louismomo66/field-eyes_pcb/field_eyes_v2_bom.csv

Refs | Value | Footprint | Qty | DNP
BT101 | 18650 Li-ion 3000mAh | field_eyes:BatteryHolder_Keystone_1042_1x18650_2pegs | 1
C101,C114 | 22uF 25V | Capacitor_SMD:C_1206_3216Metric | 2
C102,C103,C106,C107,C203,C310,C401,C402,C404,C406,C407 | 100nF | Capacitor_SMD:C_0603_1608Metric | 11
C104 | 220nF | Capacitor_SMD:C_0603_1608Metric | 1
C105,C113 | 22uF 10V | Capacitor_SMD:C_0805_2012Metric | 2
C108,C111,C202 | 10uF | Capacitor_SMD:C_0805_2012Metric | 3
C109,C110 | 47nF | Capacitor_SMD:C_0603_1608Metric | 2
C112,C201,C309,C409 | 1uF | Capacitor_SMD:C_0603_1608Metric | 4
C204 | 47uF 6.3V | Capacitor_SMD:C_1206_3216Metric | 1
C301 | 470uF 6.3V low-ESR | Capacitor_Tantalum_SMD:CP_EIA-7343-31_Kemet-D | 1
C302 | 22uF | Capacitor_SMD:C_0805_2012Metric | 1
C303 | 1uF | Capacitor_SMD:C_0402_1005Metric | 1
C304 | 100nF | Capacitor_SMD:C_0402_1005Metric | 1
C305,C313 | 33pF | Capacitor_SMD:C_0402_1005Metric | 2
C306 | 10pF | Capacitor_SMD:C_0402_1005Metric | 1
C307,C308 | 1nF | Capacitor_SMD:C_0603_1608Metric | 2
C311,C312 | NM | Capacitor_SMD:C_0402_1005Metric | 2 | DNP
C403 | 4700uF 16V | Capacitor_THT:CP_Radial_D12.5mm_P5.00mm | 1
C405,C408 | 330nF 25V | Capacitor_SMD:C_0603_1608Metric | 2
D101,D102,D103,D403 | SS14 | Diode_SMD:D_SMA | 4
D301 | ESD5Z5.0T1G | Diode_SMD:D_SOD-523 | 1
D302 | RED 0603 | LED_SMD:LED_0603_1608Metric | 1
D401,D402 | SM712 | Package_TO_SOT_SMD:SOT-23 | 2
FB301 | BLM21PG300SN1D | Inductor_SMD:L_0805_2012Metric | 1
H201,H202,H203,H204 | M3 | MountingHole:MountingHole_3.2mm_M3 | 4
J101 | SOLAR 6V | TerminalBlock_Phoenix:TerminalBlock_Phoenix_PT-1,5-2-3.5-H_1x02_P3.50mm_Horizontal | 1
J301 | U.FL LTE | Connector_Coaxial:U.FL_Hirose_U.FL-R-SMT-1_Vertical | 1
J302 | SIM holder (TE 2199337-5) | field_eyes:TE_2199337-5 | 1
J303 | MODEM USB (DNP) | Connector_PinHeader_1.27mm:PinHeader_1x06_P1.27mm_Vertical | 1 | DNP
J304 | U.FL GPS | Connector_Coaxial:U.FL_Hirose_U.FL-R-SMT-1_Vertical | 1
J403 | VALVE coil | TerminalBlock_Phoenix:TerminalBlock_Phoenix_PT-1,5-2-3.5-H_1x02_P3.50mm_Horizontal | 1
JP401 | VALVE SUPPLY | Jumper:SolderJumper-3_P1.3mm_Bridged12_RoundedPad1.0x1.5mm | 1
L101,L102 | 22uH 2A shielded | Inductor_SMD:L_Bourns_SRN6045TA | 2
L301 | 56nH | Inductor_SMD:L_0805_2012Metric | 1
Q101,Q102,Q105,Q107 | AO3401A | Package_TO_SOT_SMD:SOT-23 | 4
Q103,Q106,Q108 | 2N7002 | Package_TO_SOT_SMD:SOT-23 | 3
Q104 | FS8205 | Package_TO_SOT_SMD:SOT-23-6 | 1
Q201,Q202,Q301,Q302,Q303,Q304,Q305,Q306,Q401,Q402 | MMBT3904 | Package_TO_SOT_SMD:SOT-23 | 10
R101,R115,R120,R201,R202,R203,R204,R207,R310,R319,R402,R412 | 10k | Resistor_SMD:R_0603_1608Metric | 12
R103 | 0R12 1% 0.25W | Resistor_SMD:R_1206_3216Metric | 1
R104 | 120R | Resistor_SMD:R_0603_1608Metric | 1
R105 | 348k 1% | Resistor_SMD:R_0603_1608Metric | 1
R106 | 100k 1% | Resistor_SMD:R_0603_1608Metric | 1
R107,R108,R114,R116,R117,R421,R422 | 100k | Resistor_SMD:R_0603_1608Metric | 7
R109 | 100R | Resistor_SMD:R_0603_1608Metric | 1
R110,R320,R321 | 1k | Resistor_SMD:R_0603_1608Metric | 3
R111,R112 | 470k 1% | Resistor_SMD:R_0603_1608Metric | 2
R113,R119 | 10k 1% | Resistor_SMD:R_0603_1608Metric | 2
R118 | 191k 1% | Resistor_SMD:R_0603_1608Metric | 1
R205,R206,R301,R303,R305,R306,R307,R308,R309,R311,R401,R403,R404,R411,R413,R414 | 4.7k | Resistor_SMD:R_0603_1608Metric | 16
R302,R304,R312 | 47k | Resistor_SMD:R_0603_1608Metric | 3
R313 | 2.2k | Resistor_SMD:R_0603_1608Metric | 1
R314,R315,R316 | 22R | Resistor_SMD:R_0603_1608Metric | 3
R317 | 0R | Resistor_SMD:R_0402_1005Metric | 1
R318 | 0R | Resistor_SMD:R_0603_1608Metric | 1
R405,R406,R415,R416 | 10R | Resistor_SMD:R_0603_1608Metric | 4
R407,R417 | 120R | Resistor_SMD:R_0603_1608Metric | 2 | DNP
R423,R425 | 3.3k | Resistor_SMD:R_0603_1608Metric | 2
R424,R426 | 6.8k | Resistor_SMD:R_0603_1608Metric | 2
SV1 | PROG (as old SV1) | field_eyes:MA03-2 | 1
TH101 | 10k B3950 (under cell) | Resistor_SMD:R_0603_1608Metric | 1
TP301 | STATUS | TestPoint:TestPoint_Pad_D1.5mm | 1
U101 | CN3791 | Package_SO:SSOP-10_3.9x4.9mm_P1.00mm | 1
U102 | DW01A | Package_TO_SOT_SMD:SOT-23-6 | 1
U103 | XC6220B331MR | Package_TO_SOT_SMD:SOT-23-5 | 1
U104 | MT3608 | Package_TO_SOT_SMD:SOT-23-6 | 1
U201 | ESP32-WROOM-32D | RF_Module:ESP32-WROOM-32D | 1
U301 | A7672S | field_eyes:A7672S | 1
U302 | SMF05C | Package_TO_SOT_SMD:SOT-363_SC-70-6 | 1
U401,U402 | MAX485ESA+T | Package_SO:SOIC-8_3.9x4.9mm_P1.27mm | 2
U403 | MX1508 | Package_SO:SOIC-16_3.9x9.9mm_P1.27mm | 1
U404 | L78L09 | Package_TO_SOT_SMD:SOT-89-3 | 1
U405 | L78L05 | Package_TO_SOT_SMD:SOT-89-3 | 1
X1 | 7-in-1 NPK (A B 12V GND) | field_eyes:JST_XH_04_LongPad | 1
X2 | SMT100 (A B 12V GND) | field_eyes:JST_XH_04_LongPad | 1
X3 | OLED (3V3 GND SDA SCL) | field_eyes:JST_XH_04_LongPad | 1
X4 | DHT22 (NC 3V3 DATA GND) | field_eyes:JST_XH_04_LongPad | 1
