louismomo66/field-eyes_pcb/routing/gnd_result.txt

FAIL GND 103.33 53.275
SEG GND 0 0.35 62.1 46.9 67.1 46.9
SEG GND 0 0.35 67.1 46.9 67.2 46.8
SEG GND 1 0.35 67.2 46.8 68.1 45.9
SEG GND 1 0.35 68.1 45.9 68.2 45.9
SEG GND 1 0.35 68.2 45.9 68.3 45.8
SEG GND 1 0.35 68.3 45.8 68.8 45.8
SEG GND 1 0.35 68.8 45.8 69.2 46.2
SEG GND 1 0.35 69.2 46.2 69.2 46.3
SEG GND 1 0.35 69.2 46.3 69.3 46.4
SEG GND 1 0.35 69.3 46.4 69.3 46.8
SEG GND 1 0.35 69.3 46.8 69.5 47
VIA GND 67.2 46.8
SEG GND 0 0.35 62.076 46.893 62.1 46.9
OK GND 0.35
FAIL GND 71.14 9.93
FAIL GND 46.542 31.764
SEG GND 0 0.35 21.8 29.2 22.3 29.2
SEG GND 0 0.35 22.3 29.2 22.6 28.9
SEG GND 1 0.35 22.6 28.9 22.6 27.8
SEG GND 1 0.35 22.6 27.8 22.5 27.7
SEG GND 1 0.35 22.5 27.7 22.5 27.6
SEG GND 1 0.35 22.5 27.6 22.4 27.5
SEG GND 1 0.35 22.4 27.5 22.4 27.1
SEG GND 1 0.35 22.4 27.1 21.3 26
SEG GND 0 0.35 21.3 26 21.2 26
SEG GND 0 0.35 21.2 26 21.1 26.1
SEG GND 0 0.35 21.1 26.1 21 26.1
SEG GND 0 0.35 21 26.1 19.8 27.3
SEG GND 0 0.35 19.8 27.3 19.7 27.3
SEG GND 0 0.35 19.7 27.3 19.6 27.4
SEG GND 0 0.35 19.6 27.4 19.3 27.4
SEG GND 0 0.35 19.3 27.4 19.2 27.5
SEG GND 1 0.35 19.2 27.5 17 27.5
SEG GND 1 0.35 17 27.5 15.5 29
VIA GND 22.6 28.9
VIA GND 21.3 26
VIA GND 19.2 27.5
SEG GND 0 0.35 21.753 29.242 21.8 29.2
OK GND 0.35
FAIL GND 36.832 37.328
FAIL GND 40.326 29.577
SEG GND 0 0.35 26.6 36.6 27.1 36.6
SEG GND 0 0.35 27.1 36.6 27.3 36.8
SEG GND 0 0.35 27.3 36.8 27.4 36.8
SEG GND 0 0.35 27.4 36.8 27.5 36.9
SEG GND 0 0.35 27.5 36.9 28.2 36.9
SEG GND 0 0.35 28.2 36.9 28.3 36.8
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
SEG GND 1 0.35 17 27.5 15.5 29
VIA GND 25.7 32.3
VIA GND 21.3 26
VIA GND 19.2 27.5
SEG GND 0 0.35 26.985 32.113 27 32.1
OK GND 0.35
FAIL GND 41.799 34.005
FAIL GND 32.643 35.113
SEG GND 1 0.35 72 34 72 35.2
SEG GND 0 0.35 72 35.2 72.1 35.2
SEG GND 0 0.35 72.1 35.2 72.4 35.5
SEG GND 0 0.35 72.4 35.5 72.5 35.5
SEG GND 0 0.35 72.5 35.5 72.6 35.6
SEG GND 0 0.35 72.6 35.6 74.9 35.6
SEG GND 0 0.35 74.9 35.6 75.5 35
VIA GND 72 35.2
SEG GND 1 0.35 71.975 34 72 34
OK GND 0.35
