louismomo66/field-eyes_pcb/routing/result.txt

SEG /MODEM_VBAT 0 0.5 115.9 38.3 115.9 40
SEG /MODEM_VBAT 0 0.5 115.9 40 116 40.1
SEG /MODEM_VBAT 0 0.5 116 40.1 116 40.4
SEG /MODEM_VBAT 0 0.5 116 40.4 116.8 41.2
SEG /MODEM_VBAT 0 0.5 116.8 41.2 116.8 41.6
SEG /MODEM_VBAT 0 0.5 116.8 41.6 116.7 41.7
SEG /MODEM_VBAT 0 0.5 116.7 41.7 116.4 41.7
SEG /MODEM_VBAT 0 0.5 116.4 41.7 116 42.1
SEG /MODEM_VBAT 0 0.5 116 42.1 116 42.3
SEG /MODEM_VBAT 0 0.5 116 42.3 115.9 42.4
SEG /MODEM_VBAT 0 0.5 115.9 42.4 115.9 42.8
SEG /MODEM_VBAT 0 0.5 115.9 42.8 116 42.9
SEG /MODEM_VBAT 0 0.5 116 42.9 116 43.1
SEG /MODEM_VBAT 0 0.5 116 43.1 116.3 43.4
SEG /MODEM_VBAT 0 0.5 116.3 43.4 116.3 48
SEG /MODEM_VBAT 0 0.5 116.3 47 111.1 47
SEG /MODEM_VBAT 0 0.5 116.3 48 115.1 49.2
SEG /MODEM_VBAT 0 0.5 115.1 49.2 115.1 49.3
SEG /MODEM_VBAT 0 0.5 115.1 49.3 115 49.4
SEG /MODEM_VBAT 0 0.5 115 49.4 115 50.3
SEG /MODEM_VBAT 0 0.5 115 50.3 115.1 50.4
SEG /MODEM_VBAT 0 0.5 115.1 50.4 115.1 50.5
SEG /MODEM_VBAT 0 0.5 115.1 50.5 116.7 52.1
SEG /MODEM_VBAT 0 0.5 116.7 52.1 116.7 53
SEG /MODEM_VBAT 0 0.5 116.7 53 116.8 53.1
SEG /MODEM_VBAT 0 0.5 116.8 53.1 116.8 53.4
SEG /MODEM_VBAT 0 0.5 116.8 53.4 115.9 53.4
SEG /MODEM_VBAT 0 0.5 115.9 53.4 115.3 54
SEG /MODEM_VBAT 0 0.5 115.3 54 115 54
SEG /MODEM_VBAT 0 0.5 115 54 114.8 54.2
SEG /MODEM_VBAT 0 0.5 114.8 54.2 115.1 54.5
SEG /MODEM_VBAT 0 0.5 115.1 54.5 115.1 54.8
SEG /MODEM_VBAT 0 0.5 115.1 54.8 115.3 55
SEG /MODEM_VBAT 0 0.5 115.3 55 115.3 56.3
SEG /MODEM_VBAT 0 0.5 115.9 38.3 114.7 37.1
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
SEG GND 0 0.35 46.542 31.764 46.5 31.8
OK GND 0.35
SEG GND 0 0.35 26.6 36.6 27.9 36.6
SEG GND 0 0.35 27.9 36.6 28.3 36.2
SEG GND 0 0.35 28.3 36.2 31.5 36.2
SEG GND 0 0.35 31.5 36.2 32.6 35.1
SEG GND 0 0.35 26.618 36.553 26.6 36.6
SEG GND 0 0.35 32.643 35.113 32.6 35.1
OK GND 0.35
