louismomo66/field-eyes_pcb/field_eyes_v2.pdf

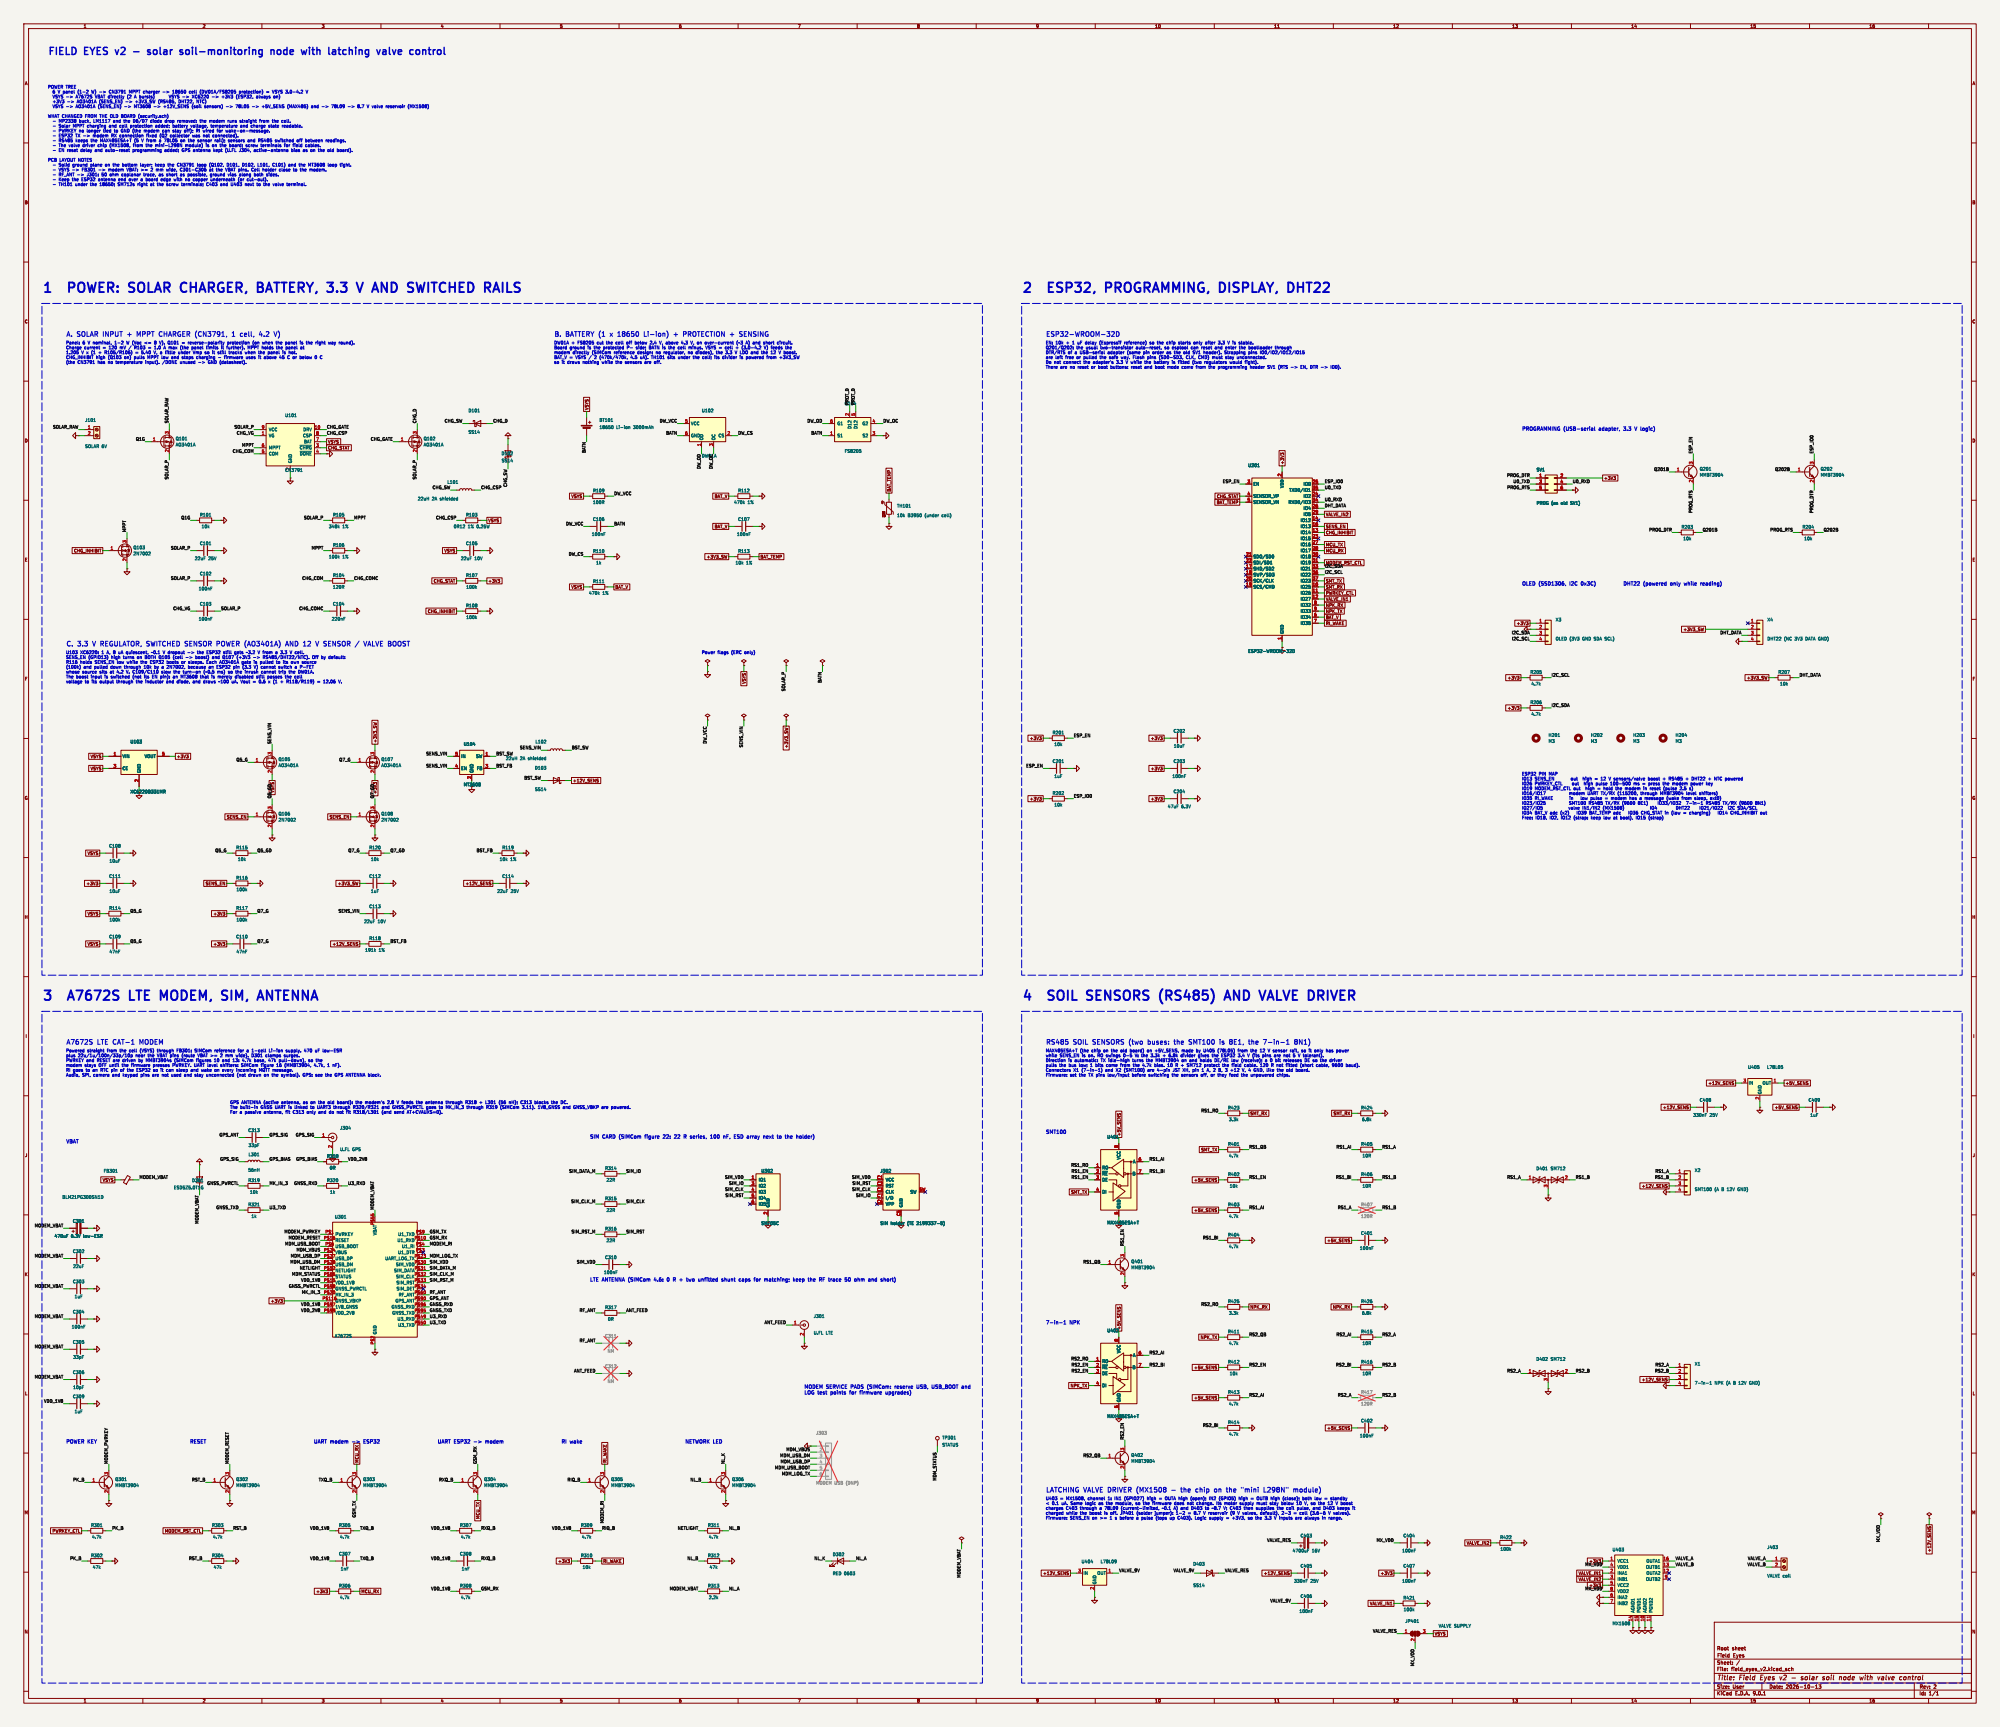
[picture p1: page 1]

1 POWER: SOLAR CHARGER, BATTERY, 3.3 V AND SWITCHED RAILS

so it draws nothing while the sensors are off.

2 DRV 10 CSP 8 BAT 7 ~{CHRG}3 ~{DONE}4 U101 CN3791

C. 3.3 V REGULATOR, SWITCHED SENSOR POWER (AO3401A) AND 12 V SENSOR / VALVE BOOST

Power flags (ERC only)

2 SW 1 FB 3 U104 MT3608 VIN 1 CE 3 GND

LTE ANTENNA (SIMCom 4.6: 0 R + two unfitted shunt caps for matching; keep the RF trace 50 ohm and short) SIM CARD (SIMCom figure 22: 22 R series, 100 nF, ESD array next to the holder)

J302 SIM holder (TE 2199337-5) VCC
C1 RST C2 CLK C3

PWRKEY P$1 RESET P$16 USB_BOOT P$6 VBUS P$24 USB_DP P$27 USB_DM P$28 NETLIGHT P$52 STATUS P$66 VDD_1V8 P$15 GNSS_PWRCTL P$98 MK_IN_3 P$20 GNSS_VBKP P$116
VDD_1V8 VDD_1V8TXQ_B MK_IN_3
