louismomo66/field-eyes_pcb/(list of files, drawings)

Other design files:
routing/field_eyes_v2.dsn
routing/field_eyes_v2_autoroute.dsn
