louismomo66/field-eyes_pcb/field_eyes_v2.kicad_pcb

## KiCad design field_eyes_v2.kicad_pcb (2026-10-22)

Schematic: field_eyes_v2.kicad_sch, Field Eyes v2 - solar soil node with valve control

Parts:
BT101: 18650 Li-ion 3000mAh; BatteryHolder_Keystone_1042_1x18650_2pegs
C101, C114: 22uF 25V; C_1206_3216Metric
C102, C103, C106, C107, C203, C310, C401, C402, C404, C406, C407: 100nF; C_0603_1608Metric
C104: 220nF; C_0603_1608Metric
C105, C113: 22uF 10V; C_0805_2012Metric
C108, C111, C202: 10uF; C_0805_2012Metric
C109, C110: 47nF; C_0603_1608Metric
C112, C201, C309, C409: 1uF; C_0603_1608Metric
C204: 47uF 6.3V; C_1206_3216Metric
C301: 470uF 6.3V low-ESR; CP_EIA-7343-31_Kemet-D
C302: 22uF; C_0805_2012Metric
C303: 1uF; C_0402_1005Metric
C304: 100nF; C_0402_1005Metric
C305, C313: 33pF; C_0402_1005Metric
C306: 10pF; C_0402_1005Metric
C307, C308: 1nF; C_0603_1608Metric
C311, C312: NM; C_0402_1005Metric; not fitted
C403: 4700uF 16V; CP_Radial_D12.5mm_P5.00mm
C405, C408: 330nF 25V; C_0603_1608Metric
D101, D102, D103, D403: SS14; D_SMA
D301: ESD5Z5.0T1G; D_SOD-523
D302: RED 0603; LED_0603_1608Metric
D401, D402: SM712; SOT-23
FB301: BLM21PG300SN1D; L_0805_2012Metric
H201, H202, H203, H204: M3; MountingHole_3.2mm_M3
J101: SOLAR 6V; TerminalBlock_Phoenix_PT-1,5-2-3.5-H_1x02_P3.50mm_Horizontal
J301: U.FL LTE; U.FL_Hirose_U.FL-R-SMT-1_Vertical
J302: SIM holder (TE 2199337-5); TE_2199337-5
J303: MODEM USB (DNP); PinHeader_1x06_P1.27mm_Vertical; not fitted
J304: U.FL GPS; U.FL_Hirose_U.FL-R-SMT-1_Vertical
J403: VALVE coil; TerminalBlock_Phoenix_PT-1,5-2-3.5-H_1x02_P3.50mm_Horizontal
JP401: VALVE SUPPLY; SolderJumper-3_P1.3mm_Bridged12_RoundedPad1.0x1.5mm
L101, L102: 22uH 2A shielded; L_Bourns_SRN6045TA
L301: 56nH; L_0805_2012Metric
Q101, Q102, Q105, Q107: AO3401A; SOT-23
Q103, Q106, Q108: 2N7002; SOT-23
Q104: FS8205; SOT-23-6
Q201, Q202, Q301, Q302, Q303, Q304, Q305, Q306, Q401, Q402: MMBT3904; SOT-23
R101, R115, R120, R201, R202, R203, R204, R207, R310, R319, R402, R412: 10k; R_0603_1608Metric
R103: 0R12 1% 0.25W; R_1206_3216Metric
R104: 120R; R_0603_1608Metric
R105: 348k 1%; R_0603_1608Metric
R106: 100k 1%; R_0603_1608Metric
R107, R108, R114, R116, R117, R421, R422: 100k; R_0603_1608Metric
R109: 100R; R_0603_1608Metric
R110, R320, R321: 1k; R_0603_1608Metric
R111, R112: 470k 1%; R_0603_1608Metric
R113, R119: 10k 1%; R_0603_1608Metric
R118: 191k 1%; R_0603_1608Metric
R205, R206, R301, R303, R305, R306, R307, R308, R309, R311, R401, R403, R404, R411, R413, R414: 4.7k; R_0603_1608Metric
R302, R304, R312: 47k; R_0603_1608Metric
R313: 2.2k; R_0603_1608Metric
R314, R315, R316: 22R; R_0603_1608Metric
R317: 0R; R_0402_1005Metric
R318: 0R; R_0603_1608Metric
R405, R406, R415, R416: 10R; R_0603_1608Metric
R407, R417: 120R; R_0603_1608Metric; not fitted
R423, R425: 3.3k; R_0603_1608Metric
R424, R426: 6.8k; R_0603_1608Metric
SV1: PROG (as old SV1); MA03-2
TH101: 10k B3950 (under cell); R_0603_1608Metric
TP301: STATUS; TestPoint_Pad_D1.5mm
U101: CN3791; SSOP-10_3.9x4.9mm_P1.00mm
U102: DW01A; SOT-23-6
U103: XC6220B331MR; SOT-23-5
U104: MT3608; SOT-23-6
U201: ESP32-WROOM-32D
U301: A7672S
U302: SMF05C; SOT-363_SC-70-6
U401, U402: MAX485ESA+T; SOIC-8_3.9x4.9mm_P1.27mm
U403: MX1508; SOIC-16_3.9x9.9mm_P1.27mm
U404: L78L09; SOT-89-3
U405: L78L05; SOT-89-3
X1: 7-in-1 NPK (A B 12V GND); JST_XH_04_LongPad
X2: SMT100 (A B 12V GND); JST_XH_04_LongPad
X3: OLED (3V3 GND SDA SCL); JST_XH_04_LongPad
X4: DHT22 (NC 3V3 DATA GND); JST_XH_04_LongPad

Connections:
+3V3: C110.1, C111.1, C202.1, C203.1, C204.1, C407.1, Q107.2 (S), R107.2, R117.1, R201.1, R202.1, R205.1, R206.1, R306.1, R310.1, SV1.2, U103.5 (VOUT), U201.2 (VDD), U301.P$116 (GNSS_VBKP), U403.1 (VCC1), U403.5 (VCC2), X3.1
+3V3_SW: C112.1, Q107.3 (D), R113.1, R207.1, X4.2
+5V_SENS: C401.1, C402.1, C409.1, R402.1, R403.1, R412.1, R413.1, U401.8 (VCC), U402.8 (VCC), U405.1 (OUT)
+12V_SENS: C114.1, C405.1, C408.1, D103.1 (K), R118.1, U404.3 (IN), U405.3 (IN), X1.3, X2.3
/ANT_FEED: C312.1, J301.1 (In), R317.2
/BATN: BT101.2 (-), C106.2, Q104.1 (S1), U102.6 (GND)
/BST_FB: R118.2, R119.1, U104.3 (FB)
/BST_SW: D103.2 (A), L102.2, U104.1 (SW)
/CHG_COM: R104.1, U101.5 (COM)
/CHG_COMC: C104.1, R104.2
/CHG_CSP: L101.2, R103.1, U101.8 (CSP)
/CHG_D: D101.2 (A), Q102.3 (D)
/CHG_GATE: Q102.1 (G), U101.10 (DRV)
/CHG_SW: D101.1 (K), D102.1 (K), L101.1
/CHG_VG: C103.1, U101.1 (VG)
/DHT_DATA: R207.2, U201.26 (IO4), X4.3
/DW_CS: R110.1, U102.2 (CS)
/DW_OC: Q104.4 (G2), U102.3 (OC)
/DW_OD: Q104.6 (G1), U102.1 (OD)
/DW_VCC: C106.1, R109.2, U102.5 (VCC)
/ESP_EN: C201.1, Q201.3 (C), R201.2, U201.3 (EN)
/ESP_IO0: Q202.3 (C), R202.2, U201.25 (IO0)
/GNSS_PWRCTL: R319.1, U301.P$98 (GNSS_PWRCTL)
/GNSS_RXD: R320.1, U301.P$96 (GNSS_RXD)
/GNSS_TXD: R321.1, U301.P$95 (GNSS_TXD)
/GPS_ANT: C313.1, U301.P$90 (GPS_ANT)
/GPS_BIAS: L301.2, R318.1
/GPS_SIG: C313.2, J304.1 (In), L301.1
/GSM_RX: Q304.3 (C), R308.2, U301.P$10 (U1_RXD)
/GSM_TX: Q303.2 (E), U301.P$9 (U1_TXD)
/I2C_SCL: R205.2, U201.36 (IO22), X3.4
/I2C_SDA: R206.2, U201.33 (IO21), X3.3
/MDM_LOG_TX: J303.6, U301.P$23 (UART_LOG_TX)
/MDM_STATUS: TP301.1, U301.P$66 (STATUS)
/MDM_USB_BOOT: J303.5, U301.P$6 (USB_BOOT)
/MDM_USB_DM: J303.3, U301.P$28 (USB_DM)
/MDM_USB_DP: J303.4, U301.P$27 (USB_DP)
/MDM_VBUS: J303.2, U301.P$24 (VBUS)
/MK_IN_3: R319.2, U301.P$20 (MK_IN_3)
/MODEM_PWRKEY: Q301.3 (C), U301.P$1 (PWRKEY)
/MODEM_RESET: Q302.3 (C), U301.P$16 (RESET)
/MODEM_RI: Q305.2 (E), U301.P$4 (U1_RI)
/MODEM_VBAT: C301.1, C302.1, C303.1, C304.1, C305.1, C306.1, D301.1 (K), FB301.2, R313.1, U301.P$55 (VBAT), U301.P$56 (VBAT), U301.P$57 (VBAT)
/MPPT: Q103.3 (D), R105.2, R106.1, U101.6 (MPPT)
/MX_VDD: C404.1, JP401.2 (C), U403.4 (VDD1), U403.8 (VDD2)
/NETLIGHT: R311.1, U301.P$52 (NETLIGHT)
/NL_A: D302.2 (A), R313.2
/NL_B: Q306.1 (B), R311.2, R312.1
/NL_K: D302.1 (K), Q306.3 (C)
/PK_B: Q301.1 (B), R301.2, R302.1
/PROG_DTR: Q202.2 (E), R203.1, SV1.1
/PROG_RTS: Q201.2 (E), R204.1, SV1.5
/PROT_D: Q104.2 (D12), Q104.5 (D12)
/Q1G: Q101.1 (G), R101.1
/Q5_G: C109.2, Q105.1 (G), R114.2, R115.1
/Q5_GD: Q106.3 (D), R115.2
/Q7_G: C110.2, Q107.1 (G), R117.2, R120.1
/Q7_GD: Q108.3 (D), R120.2
/Q201B: Q201.1 (B), R203.2
/Q202B: Q202.1 (B), R204.2
/RF_ANT: C311.1, R317.1, U301.P$60 (RF_ANT)
/RIQ_B: Q305.1 (B), R309.2
/RS1_A: D401.1 (A1), R405.2, R407.1, X2.1
/RS1_AI: R403.2, R405.1, U401.6 (A)
/RS1_B: D401.2 (A2), R406.2, R407.2, X2.2
/RS1_BI: R404.1, R406.1, U401.7 (B)
/RS1_EN: Q401.3 (C), R402.2, U401.2 (~RE), U401.3 (DE)
/RS1_QB: Q401.1 (B), R401.2
/RS1_RO: R423.1, U401.1 (RO)
/RS2_A: D402.1 (A1), R415.2, R417.1, X1.1
/RS2_AI: R413.2, R415.1, U402.6 (A)
/RS2_B: D402.2 (A2), R416.2, R417.2, X1.2
/RS2_BI: R414.1, R416.1, U402.7 (B)
/RS2_EN: Q402.3 (C), R412.2, U402.2 (~RE), U402.3 (DE)
/RS2_QB: Q402.1 (B), R411.2
/RS2_RO: R425.1, U402.1 (RO)
/RST_B: Q302.1 (B), R303.2, R304.1
/RXQ_B: C308.2, Q304.1 (B), R307.2
/SENS_VIN: C113.1, L102.1, Q105.3 (D), U104.4 (EN), U104.5 (IN)
/SIM_CLK: J302.C3 (CLK), R315.2, U302.4 (IO3)
/SIM_CLK_M: R315.1, U301.P$32 (SIM_CLK)
/SIM_DATA_M: R314.1, U301.P$31 (SIM_DATA)
/SIM_IO: J302.C7 (I/O), R314.2, U302.3 (IO2)
/SIM_RST: J302.C2 (RST), R316.2, U302.5 (IO4)
/SIM_RST_M: R316.1, U301.P$33 (SIM_RST)
/SIM_VDD: C310.1, J302.C1 (VCC), U301.P$30 (SIM_VDD), U302.1 (IO1)
/SOLAR_P: C101.1, C102.1, C103.2, Q101.2 (S), Q102.2 (S), R105.1, U101.9 (VCC)
/SOLAR_RAW: J101.1, Q101.3 (D)
/TXQ_B: C307.2, Q303.1 (B), R305.2
/U0_RXD: SV1.4, U201.34 (RXD0/IO3)
/U0_TXD: SV1.3, U201.35 (TXD0/IO1)
/U3_RXD: R320.2, U301.P$49 (U3_RXD)
/U3_TXD: R321.2, U301.P$50 (U3_TXD)
/VALVE_9V: C406.1, D403.2 (A), U404.1 (OUT)
/VALVE_A: J403.1, U403.16 (OUTA1)
/VALVE_B: J403.2, U403.13 (OUTB1)
/VALVE_RES: C403.1, D403.1 (K), JP401.1 (A)
/VDD_1V8: C307.1, C308.1, C309.1, R305.1, R307.1, R308.1, R309.1, U301.P$15 (VDD_1V8), U301.P$97 (1V8_GNSS)
/VDD_2V8: R318.2, U301.P$99 (VDD_2V8)
BAT_TEMP: R113.2, TH101.1, U201.5 (SENSOR_VN)
BAT_V: C107.1, R111.2, R112.1, U201.6 (IO34)
CHG_INHIBIT: Q103.1 (G), R108.1, U201.13 (IO14)
CHG_STAT: R107.1, U101.3 (~CHRG), U201.4 (SENSOR_VP)
GND: C101.2, C102.2, C104.2, C105.2, C107.2, C108.2, C111.2, C112.2, C113.2, C114.2, C201.2, C202.2, C203.2, C204.2, C301.2, C302.2, C303.2, C304.2, C305.2, C306.2, C309.2, C310.2, C311.2, C312.2, C401.2, C402.2, C403.2, C404.2, C405.2, C406.2, C407.2, C408.2, C409.2, D102.2 (A), D301.2 (A), D401.3 (common), D402.3 (common), J101.2, J301.2 (Ext), J302.C5 (GND), J302.G1 (GND), J302.G2 (GND), J302.G3 (GND), J302.G4 (GND), J303.1, J304.2 (Ext), Q103.2 (S), Q104.3 (S2), Q106.2 (S), Q108.2 (S), Q301.2 (E), Q302.2 (E), Q306.2 (E), Q401.2 (E), Q402.2 (E), R101.2, R106.2, R108.2, R110.2, R112.2, R116.2, R119.2, R302.2, R304.2, R312.2, R404.2, R414.2, R421.2, R422.2, R424.2, R426.2, SV1.6, TH101.2, U101.2 (GND), U101.4 (~DONE), U103.2 (GND), U104.2 (GND), U201.1 (GND), U201.15 (GND), U201.38 (GND), U201.39 (GND), U301.P$2 (GND), U301.P$17 (GND), U301.P$18 (GND), U301.P$29 (GND), U301.P$39 (GND), U301.P$45 (GND), U301.P$46 (GND), U301.P$54 (GND), U301.P$58 (GND), U301.P$59 (GND), U301.P$61 (GND), U301.P$62 (GND), U301.P$63 (GND), U301.P$64 (GND), U301.P$65 (GND), U301.P$69 (GND), U301.P$70 (GND), U301.P$71 (GND), U301.P$72 (GND), U301.P$73 (GND), U301.P$74 (GND), U301.P$75 (GND), U301.P$76 (GND), U301.P$77 (GND), U301.P$78 (GND), U301.P$79 (GND), U301.P$80 (GND), U301.P$81 (GND), U301.P$82 (GND), U301.P$83 (GND), U301.P$84 (GND), U301.P$85 (GND), U301.P$86 (GND), U301.P$87 (GND), U301.P$88 (GND), U301.P$89 (GND), U301.P$91 (GND), U301.P$92 (GND), U301.P$94 (GND), U302.2 (GND), U401.5 (GND), U402.5 (GND), U403.6 (INA2), U403.7 (INB2), U403.10 (AGND2), U403.11 (PGND2), U403.14 (AGND1), U403.15 (PGND1), U404.2 (GND), U405.2 (GND), X1.4, X2.4, X3.2, X4.4
MCU_RX: Q303.3 (C), R306.2, U201.28 (IO17)
MCU_TX: Q304.2 (E), U201.27 (IO16)
MODEM_RST_CTL: R303.1, U201.31 (IO19)
NPK_RX: R425.2, R426.1, U201.8 (IO32)
NPK_TX: R411.1, U201.9 (IO33), U402.4 (DI)
PWRKEY_CTL: R301.1, U201.11 (IO26)
RI_WAKE: Q305.3 (C), R310.2, U201.7 (IO35)
SENS_EN: Q106.1 (G), Q108.1 (G), R116.1, U201.16 (IO13)
SMT_RX: R423.2, R424.1, U201.10 (IO25)
SMT_TX: R401.1, U201.37 (IO23), U401.4 (DI)
VALVE_IN1: R421.1, U201.12 (IO27), U403.2 (INA1)
VALVE_IN2: R422.1, U201.29 (IO5), U403.3 (INB1)
VSYS: BT101.1 (+), C105.1, C108.1, C109.1, FB301.1, JP401.3 (B), Q105.2 (S), R103.2, R109.1, R111.1, R114.1, U101.7 (BAT), U103.1 (VIN), U103.3 (CE)

Notes on the sheet:
A. SOLAR INPUT + MPPT CHARGER (CN3791, 1 cell, 4.2 V)
Panel: 6 V nominal, 1-2 W (Voc <= 8 V). Q101 = reverse-polarity protection (on when the panel is the right way round). Charge current = 120 mV / R103 = 1.0 A max (the panel limits it further). MPPT holds the panel at 1.205 V x (1 + R105/R106) = 5.40 V, a little under Vmp so it still tracks when the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
B. BATTERY (1 x 18650 Li-ion) + PROTECTION + SENSING
DW01A + FS8205 cut the cell off below 2.4 V, above 4.3 V, on over-current (~3 A) and short circuit. Board ground is the protected P- side; BATN is the cell minus. VSYS = cell + (3.0-4.2 V) feeds the modem directly (SIMCom reference design: no regulator, no diodes), the 3.3 V LDO and the 12 V boost.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
C. 3.3 V REGULATOR, SWITCHED SENSOR POWER (AO3401A) AND 12 V SENSOR / VALVE BOOST
U103 XC6220: 1 A, 8 uA quiescent, ~0.1 V dropout -> the ESP32 still gets ~3.2 V from a 3.3 V cell. SENS_EN (GPIO13) high turns on BOTH Q105 (cell -> boost) and Q107 (+3V3 -> RS485/DHT22/NTC). Off by default: R116 holds SENS_EN low while the ESP32 boots or sleeps. Each AO3401A gate is pulled to its 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
Power flags (ERC only)
1 POWER: SOLAR CHARGER, BATTERY, 3.3 V AND SWITCHED RAILS
ESP32-WROOM-32D
EN: 10k + 1 uF delay (Espressif reference) so the chip starts only after 3.3 V is stable. Q201/Q202: the usual two-transistor auto-reset, so esptool can reset and enter the bootloader through DTR/RTS of a USB-serial adapter (same pin order as the old SV1 header). Strapping pins IO0/IO2/IO12/IO15 ar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
PROGRAMMING (USB-serial adapter, 3.3 V logic)
OLED (SSD1306, I2C 0x3C) DHT22 (powered only while reading)
ESP32 PIN MAP IO13 SENS_EN out high = 12 V sensors/valve boost + RS485 + DHT22 + NTC powered IO26 PWRKEY_CTL out high pulse 100-500 ms = press the modem power key IO19 MODEM_RST_CTL out high = hold the modem in reset (pulse 2.5 s) IO16/IO17 modem UART TX/RX (115200, through MMBT3904 level shifters)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
2 ESP32, PROGRAMMING, DISPLAY, DHT22
A7672S LTE CAT-1 MODEM
Powered straight from the cell (VSYS) through FB301: SIMCom reference for a 1-cell Li-ion supply. 470 uF low-ESR plus 22u/1u/100n/33p/10p near the VBAT pins (route VBAT >= 2 mm wide). D301 clamps surges. PWRKEY and RESET are driven by MMBT3904s (SIMCom figures 10 and 13: 4.7k base, 47k pull-down), 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
VBAT
POWER KEY
RESET
UART modem -> ESP32
UART ESP32 -> modem
RI wake
NETWORK LED
SIM CARD (SIMCom figure 22: 22 R series, 100 nF, ESD array next to the holder)
LTE ANTENNA (SIMCom 4.6: 0 R + two unfitted shunt caps for matching; keep the RF trace 50 ohm and short)
MODEM SERVICE PADS (SIMCom: reserve USB, USB_BOOT and LOG test points for firmware upgrades)
3 A7672S LTE MODEM, SIM, ANTENNA
RS485 SOIL SENSORS (two buses: the SMT100 is 8E1, the 7-in-1 8N1)
MAX485ESA+T (the chip on the old board) on +5V_SENS, made by U405 (78L05) from the 12 V sensor rail, so it only has power while SENS_EN is on. RO swings 0-5 V: the 3.3k + 6.8k divider gives the ESP32 3.4 V (its pins are not 5 V tolerant). Direction is automatic: TX idle-high turns the MMBT3904 on a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
SMT100
7-in-1 NPK
LATCHING VALVE DRIVER (MX1508 - the chip on the "mini L298N" module)
U403 = MX1508, channel 1: IN1 (GPIO27) high = OUTA high (open); IN2 (GPIO5) high = OUTB high (close); both low = standby < 0.1 uA. Same logic as the module, so the firmware does not change. Its motor supply must stay below 10 V, so the 12 V boost charges C403 through a 78L09 (current-limited, ~0.1 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
4 SOIL SENSORS (RS485) AND VALVE DRIVER
FIELD EYES v2 - solar soil-monitoring node with latching valve control
POWER TREE 6 V panel (1-2 W) -> CN3791 MPPT charger -> 18650 cell (DW01A/FS8205 protection) = VSYS 3.0-4.2 V VSYS -> A7672S VBAT directly (2 A bursts) VSYS -> XC6220 -> +3V3 (ESP32, always on) +3V3 -> AO3401A (SENS_EN) -> +3V3_SW (RS485, DHT22, NTC) VSYS -> AO3401A (SENS_EN) -> MT3608 -> +12V_SENS 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
GPS ANTENNA (active antenna, as on the old board): the modem's 2.8 V feeds the antenna through R318 + L301 (56 nH); C313 blocks the DC. The built-in GNSS UART is linked to UART3 through R320/R321 and GNSS_PWRCTL goes to MK_IN_3 through R319 (SIMCom 3.11). 1V8_GNSS and GNSS_VBKP are powered. For a p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

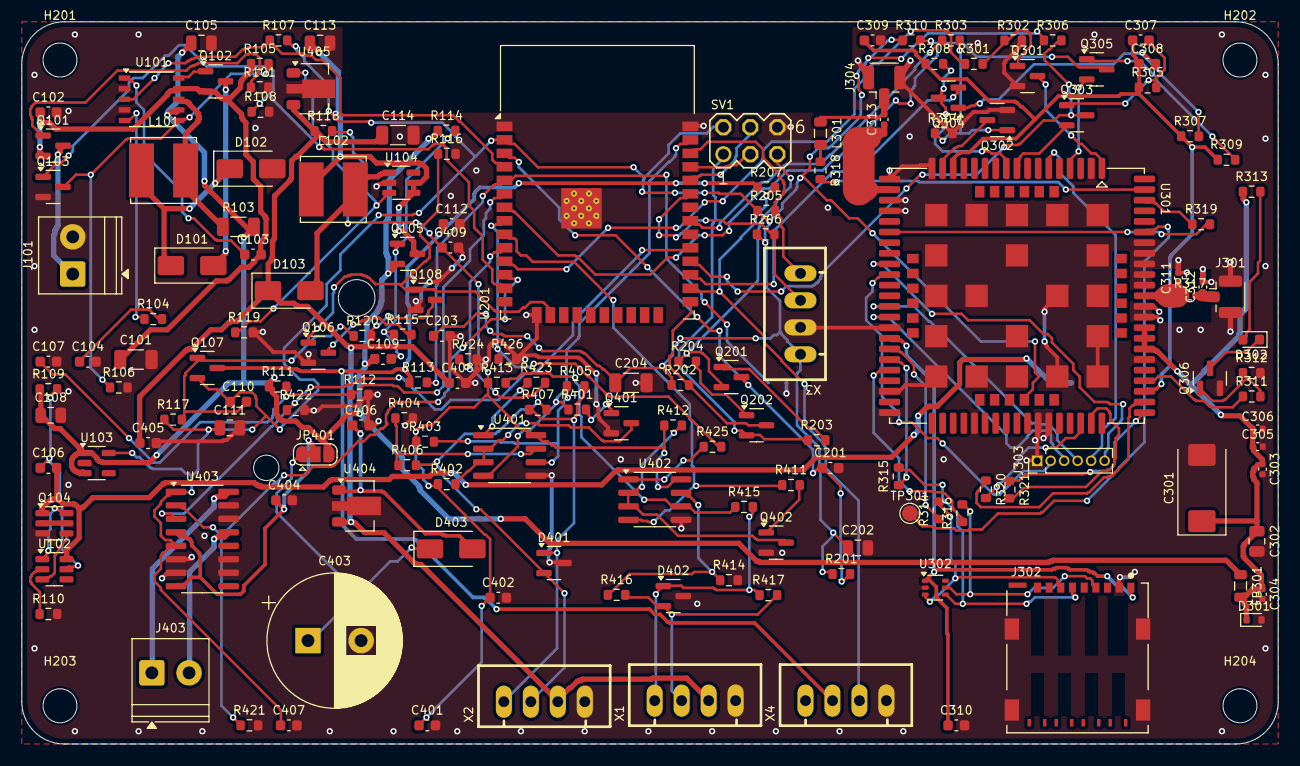
[picture p2: board field_eyes_v2.kicad_pcb from above]

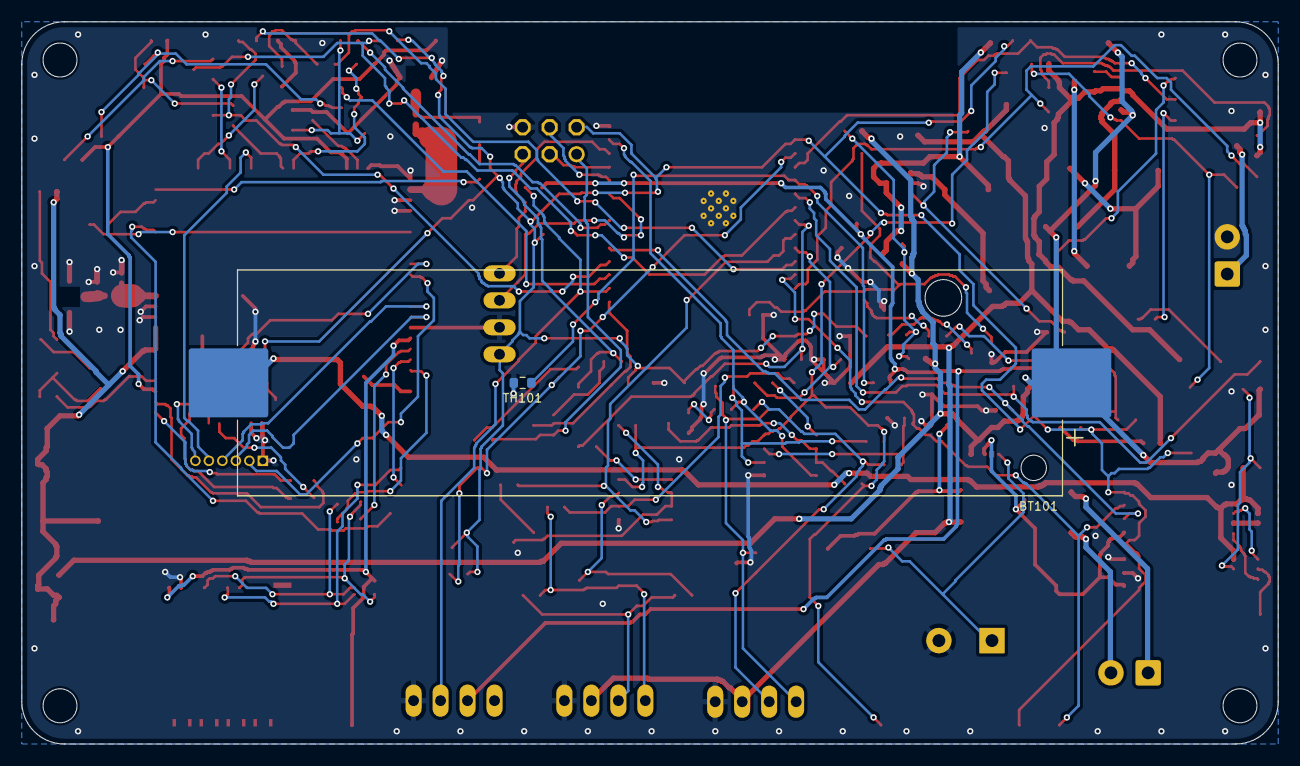
[picture p3: board field_eyes_v2.kicad_pcb from below]

Board: 2 copper layers, 118.3 x 68.0 mm, 168 parts (2 on the bottom side), 117 nets.
