louismomo66/field-eyes_pcb/(commit log)

2026-10-21 new pcb
    [field_eyes_v2.dsn, field_eyes_v2.kicad_pcb, field_eyes_v2.kicad_sch, field_eyes_v2_bom.csv, io.kicad_sch, mcu.kicad_sch, modem.kicad_sch, power.kicad_sch]
2026-10-21 repositioned ccomponents
    [field_eyes_v2.before_gnss.kicad_pcb, field_eyes_v2.before_gnss.kicad_sch, field_eyes_v2.before_max485.kicad_pcb, field_eyes_v2.before_max485.kicad_sch, field_eyes_v2.before_old_layout.kicad_pcb, field_eyes_v2.before_spread.kicad_pcb, field_eyes_v2.dsn, field_eyes_v2.kicad_pcb]
2026-10-21 removed buttons
    [field_eyes_v2.before_box_fit.kicad_pcb, field_eyes_v2.before_button_removal.kicad_pcb, field_eyes_v2.before_button_removal.kicad_sch, field_eyes_v2.dsn, field_eyes_v2.kicad_pcb, field_eyes_v2.kicad_sch, field_eyes_v2_bom.csv]
2026-10-21 spaced components
    [field_eyes_v2.before_gps_corridor.kicad_pcb, field_eyes_v2.before_spreading.kicad_pcb, field_eyes_v2.dsn, field_eyes_v2.kicad_pcb, field_eyes_v2_autoroute.dsn]
2026-10-22 routed the board
    [before_fragments.kicad_pcb, before_full_routing.kicad_pcb, before_ground_planes.kicad_pcb, before_stitching.kicad_pcb, before_stub_removal.kicad_pcb, field_eyes_v2.before_antenna_routing.kicad_pcb, field_eyes_v2.dsn, field_eyes_v2.kicad_pcb]
